NTHSynth/NTH_DSP/readme.txt

More information about the NTH Music Synthesizer can be found at: nthsynth.com
