NTHSynth/NTH_DSP/Firmware/readme.txt

To compile the NTH source code, create a new project for the PIC16F1937 microcontroller using MPLAB IDE.  Add the linker script (.lkr), include (.inc), and assembler files to the project (.asm).
