NTHSynth/NTH_DSP/PCB/readme.txt

Part: NTH
Revision: D

File List:

NTH-Rev-D-BOM.xls - Bill of Materials
NTH-d-centroid.csv - Centroid
NTH-d.brd - Eagle 4.16 board design

NTH-d.bot - Gerber, bottom layer
NTH-d.oln - Gerber, board outline
NTH-d.smt - Gerber, top soldermask
NTH-d.smb - Gerber, bottom soldermask
NTH-d.slk - Gerber, top silkscreen
NTH-d.top - Gerber, top layer
NTH-d.tsp - Gerber, top silkscreen
NTH-d.drd - Excellon Drill File
