NTHSynth/NTH_DSP/Enclosure/Enclosure-BOM.xls

NTH Rev D Enclosure BOM
Item # | Qty | MFG Part No. | Digikey Part No. | Mouser Part No. | Description | Notes
1 | 8 | 1848 | 1848K-ND | 534-1848 | Spacer, Round, 7/8"
2 | 24 |  | H360-ND |  | Machine Screw, Round Head, 6/32, 1/2"
3 | 8 |  | H220-ND |  | 6/32 Hex Nut
4 | 4 | 720 | 720K-ND | 534-720 | Rubber Foot
5 | 4 |  | H781-ND |  | 4/40 machine screw, pan head, 3/8" – for rubber feet
6 | 4 |  | H216-ND |  | 4/40 nut – for rubber feet
