NTHSynth/NTH_DSP/PCB/NTH-Rev-D-BOM.xls

NTH Rev D BOM
Item # | Type | SMT Qty | Thru Qty | Qty – Other | PCB Side | Ref Des | MFG Part No. | Digikey Part No. | Mouser Part No. | Description | Package | Notes
1 | SMT | 9 |  |  | Top | C1-C6, C101-C103 | C0805C104K3RACTU |  | 80-C0805C104K3R | Capacitor, Ceramic, 0.1uF | '0805
2 |  |  |  |  |  | C7 |  |  |  |  |  | Do not stuff
3 | SMT | 2 |  |  | Top | C11, C12 |  |  | 647-UWT1V2R2MCL2B | Capacitor, Electrolytic, 2.2uF | Radial
4 |  |  |  |  |  | C13 |  |  |  |  |  | Do not stuff
5 | SMT | 1 |  |  | Top | C104 | C0805C105K3PACTU |  | 80-C0805C105K3P | Capacitor, Ceramic, 1.0uF | '0805
6 | SMT | 13 |  |  | Top | D1-D12, D14 |  |  | 833-1N4148W-TP | Small Signal Diode | SOD123
7 | SMT | 3 |  |  | Top | D13, D101, D102 |  |  | 833-S2D-TP | Rectifier Diode
8 | Thru |  | 1 |  | Bottom | JP1 |  |  | 806-STX-3100-3N | 3.5mm Stereo Phone Jack
9 | Thru |  | 1 |  | Bottom | JP2 | 22-28-8061 |  | 538-22-28-8061 | ICSP Header
10 | Thru |  | 2 |  | Bottom | JP3, JP4 | SDS-50J | CP-2350-ND |  | MIDI Connector
11 | Other |  |  | 2 |  |  | 48SM006 |  | 48SM006 | M2 Self Tapping Screw |  | Anchors JP3 and JP4
12 | Thru |  | 13 |  | Top | LED1-LED13 | VAOL-5LSBY2 |  | 593-VAOL-5LSBY2 | LED | T1 ¾ | Use spacer (Item #10)
13 | Other |  |  | 13 |  | LED-SPACER | 8318 | 8318K-ND | 534-8318 |  |  | Spacer for LED1-LED13
14 | Thru |  | 8 |  | Top | POT1-POT8 |  |  | 312-619BF-5K | Potentiometer, Slide
15 | Thru |  | 3 |  | Top | POT9-POT11 |  |  | 317-2090F-10K | Potentiometer, 9mm, Rotary, Linear, 10k
16 | Thru |  | 2 |  | Top | PVOL, PRES |  |  | 317-2080F-10K | Potentiometer, 9mm, Rotary, Audio, 10k
17 | Thru |  | 1 |  | Top | PCUT |  |  | 317-2090F-100K | Potentiometer, 9mm, Rotary, Linear, 100k
18 | SMT | 2 |  |  | Top | R1, R101 |  |  | 667-ERJ-6GEYJ332V | R 3.3k ohms | '0805
19 | SMT | 1 |  |  | Top | R2 |  |  | 667-ERJ-6GEYJ471V | R 470 ohms | '0805
20 | SMT | 1 |  |  | Top | R102 |  |  | 667-ERJ-6GEYJ472V | R 4.7k ohms | '0805
21 | SMT | 2 |  |  | Top | R103-R104 |  |  | 667-ERJ-6GEYJ101V | R 100 ohms | '0805
22 | SMT | 2 |  |  | Top | R105-R106 |  |  | 667-ERJ-6GEYJ103V | R 10k ohms | '0805
23 | SMT | 2 |  |  | Top | R107-R108 |  |  | 667-ERJ-6GEYJ104V | R 100k ohms | '0805
24 | SMT | 2 |  |  | Top | R109-R110 |  |  | 667-ERJ-6GEYJ221V | R 220 ohms | '0805
25 | SMT | 1 |  |  | Top | R111 |  |  | 667-ERJ-6GEYJ222V | R 2.2k ohms | '0805 | Increase value up to 10k or remove R111 completely for greater resonance.
26 | SMT | 1 |  |  | Top | RN1 |  |  | 774-744C083102JP | Resistor Network, 8 pads, 1kohm
27 | SMT | 1 |  |  | Top | RN2 |  |  | 774-744C083221JP | Resistor Network, 8 pads, 220ohm
28 | SMT | 12 |  |  | Top | SW1-SW12 | TL3301SPF160QG | EG1869CT-ND |  | Tact Switch
29 | Other |  |  | 12 |  |  | 1S-BLK | EG4379-ND | 612-1S-BLK |  |  | Caps for SW1-SW12
30 | Thru |  | 2 |  | Top | SW13, SW14 | G12KP-YA-RO |  | 633-G12KP-YA-RO | Rocker Switch
31 | SMT | 1 |  |  | Top | U1 | PIC16F1937-I/PT | PIC16F1937-I/PT-ND | 579-PIC16F1937-I/PT | Microcontroller | TQFP-44
32 | SMT | 1 |  |  | Top | U2 | AD7302BRZ | AD7302BRZ-ND |  | DAC | SOIC-20
33 | SMT | 1 |  |  | Top | U3 |  |  | 511-L4931CD50-TR | Voltage Regulator | SO-8
34 | SMT | 1 |  |  | Top | U4 | PC900V0NIPXF |  | 852-PC900V0NIPXF | Photocoupler
35 | SMT | 3 |  |  | Top | U101-U103 |  |  | 579-MCP6001T-I/OT | Op Amp | SOT-23-5
36 | Thru |  | 1 |  | Bottom | BATTERY | 1294 |  | 534-1294 | Battery Holder |  | Attach to PCB with 4 eyelets (Item #33)
37 | Other |  |  | 4 |  | EYELET | 46 |  | 534-46 | Eyelet
Totals: |  | 62 | 34 | 31
