NTHSynth/NTH_DSP/Manual/NTH_manual_1.26.2012d.pdf

# The NTH Music Synthesizer

manual revision: 1.26.2012d

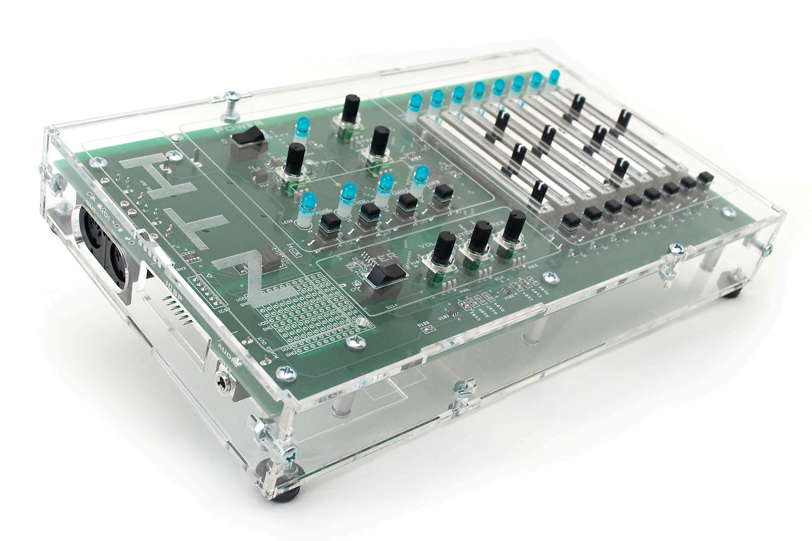
[picture p1: figure]

Thank you.

Congratulations on purchasing the Nth Music Synthesizer.

We hope that the NTH will put a smile on your face for years to come.

2

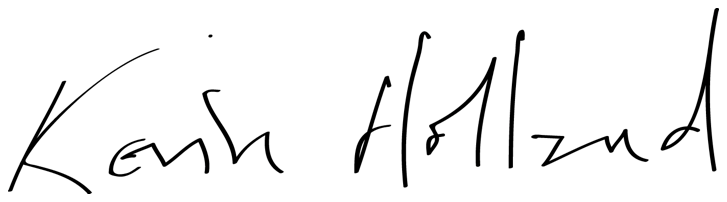
[picture p2: figure]
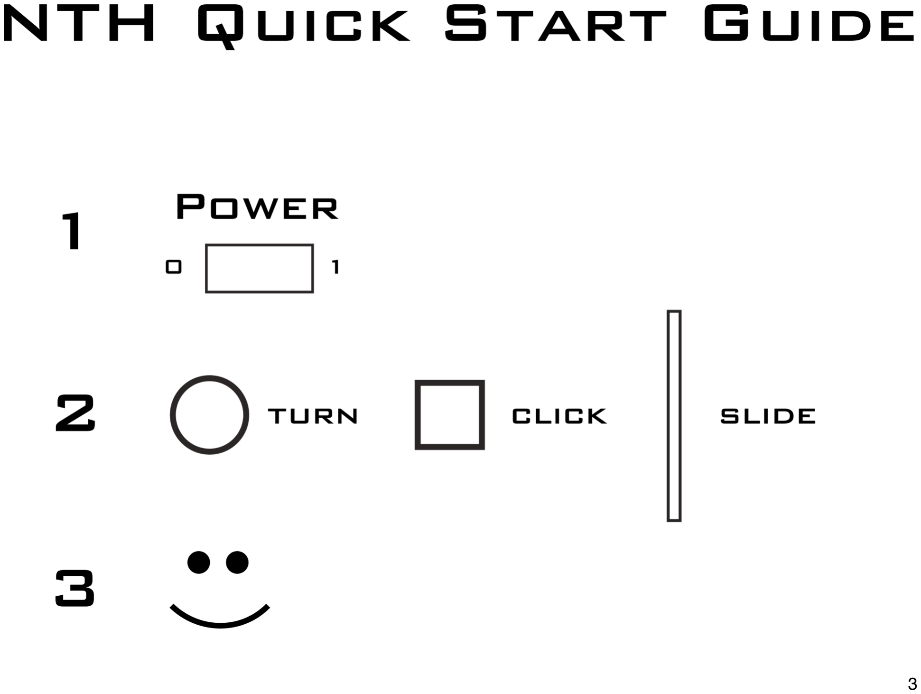
[picture p3: page 3]

3

## Contents

4

Introduction

Top Panel

Sequencer

Modulation

Filter

Signal Flow

Midi

Programming

Features & Specifications

Credits

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
## Introduction

We designed the NTH so that a user manual would be unnecessary. The NTH is so simple to use that a novice can quickly craft a variety of timbres. For the synth veteran, the NTH is a fun tool without layered menus and obscured features. Every synthesis parameter can be altered by simple manipulation of a knob, button, or slider.

If you are interested in the specifics of NTH operation, read on. We are excited to share.

5

6

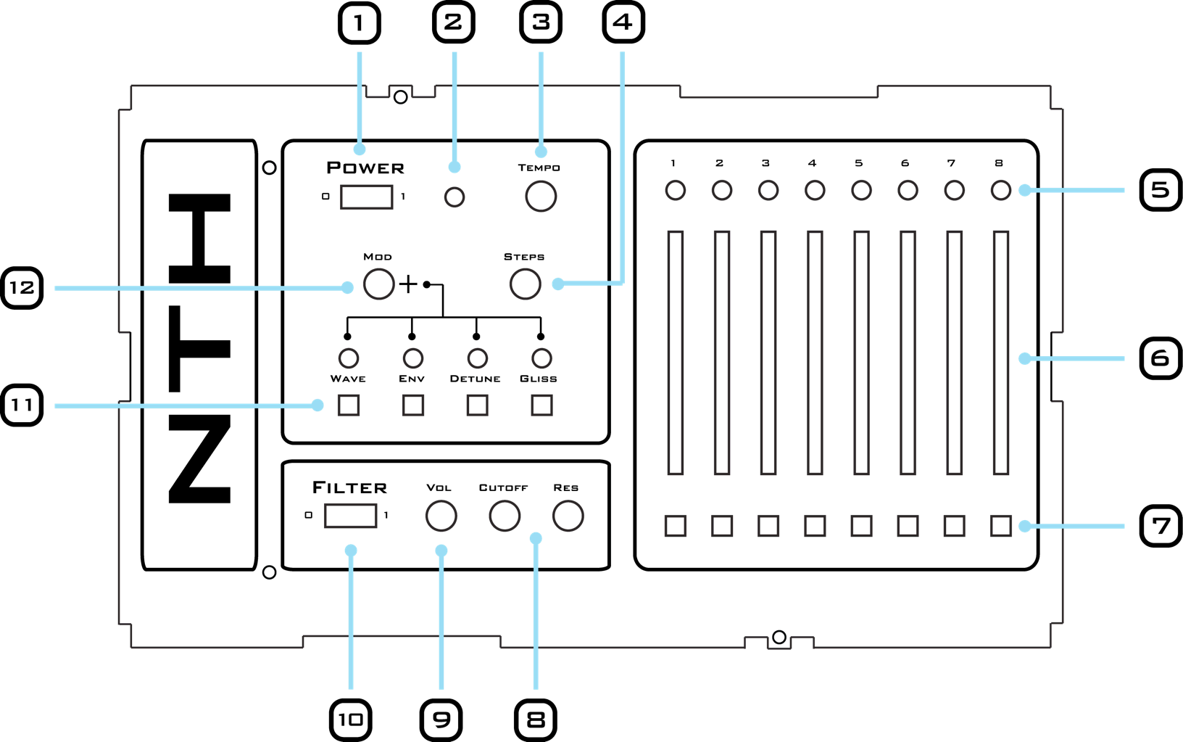
[picture p4: figure]

1 Power Toggle
2 Power indicator LED
3 Tempo Knob
4 Steps Knob
5 Step Indicator LEDs
6 Pitch Sliders

7 Step Toggles
8 Filter (Cutoff/Resonance Knobs) 9 Volume Knob
10 Filter Bypass Toggle
11 Modulation Toggles
12 Modulation Knob

## Top Panel

## Sequencer

7

Power up the NTH.
The sequencer
begins running.

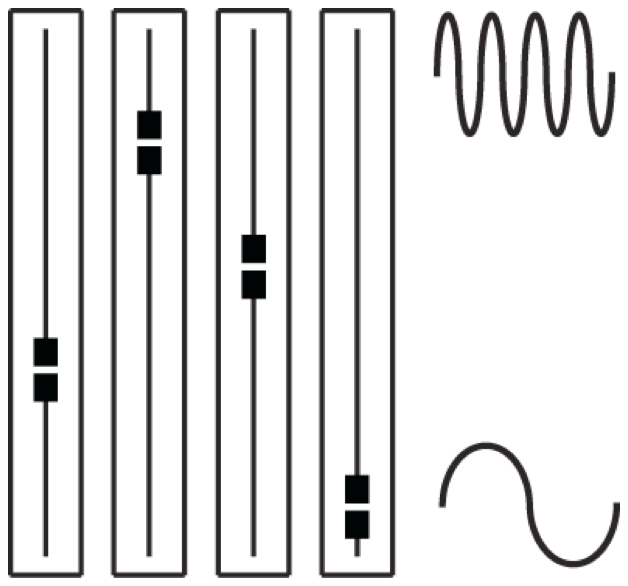
[picture p5: figure]

Change the pitch
of each step with
the sliders.

8

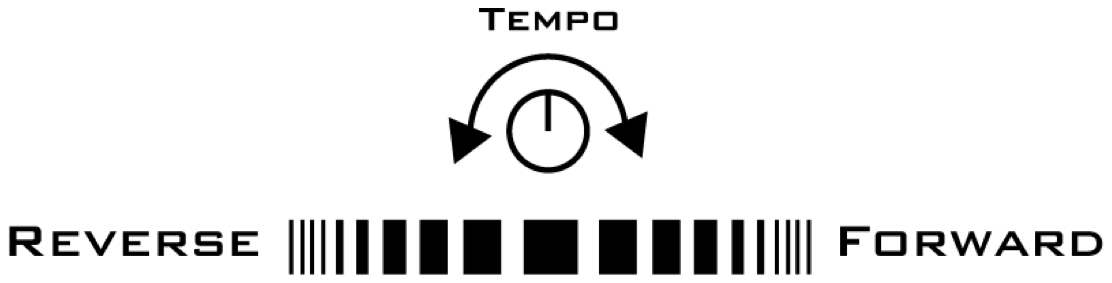
[picture p6: figure]

Adjust speed
and direction
of playback.

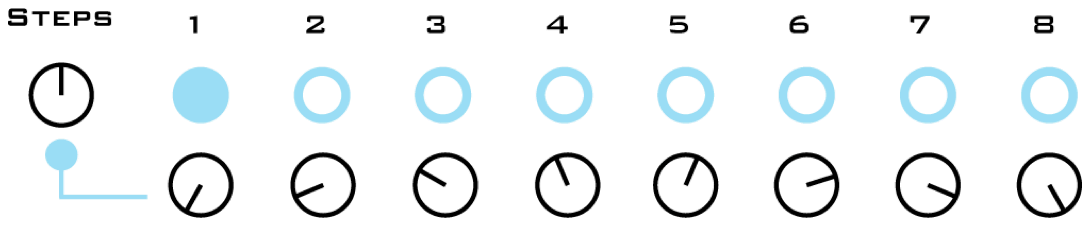
[picture p7: figure]

Toggle each step on or off.

Select the number
of steps in the
sequence.

## Modulation

Select any of the modulation parameters (Wave, Env, Detune, Gliss) by pressing the corresponding toggle. Adjust the sound by turning the Modulation Knob.

Each modulation parameter is described in the pages that follow.

9

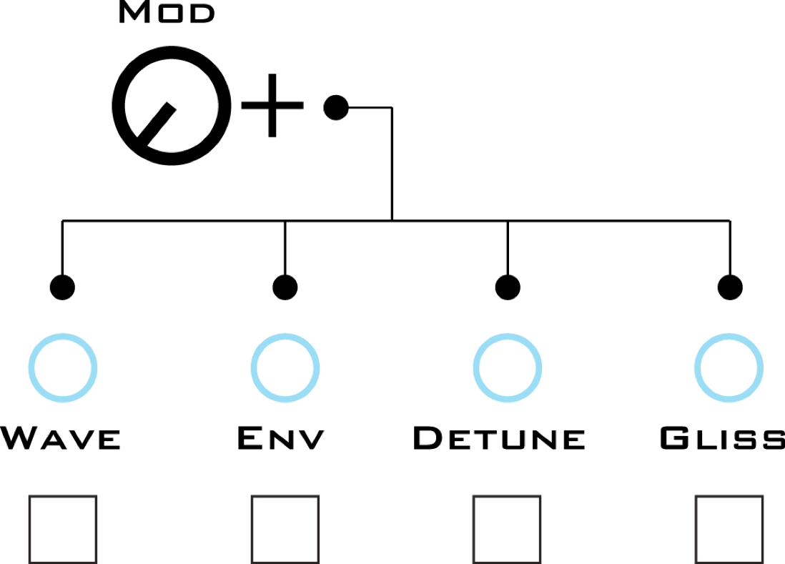
[picture p8: figure]

## Waveforms

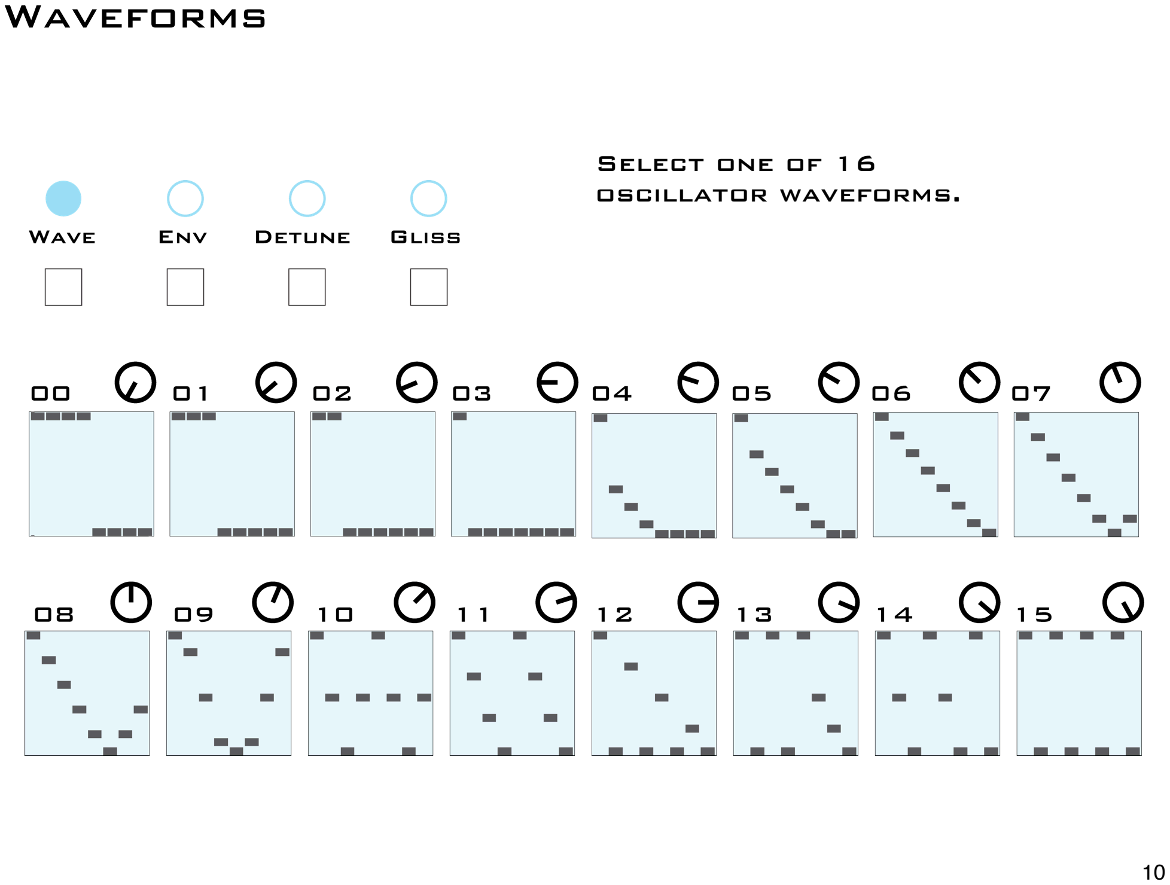
[picture p9: page 10]

10

Select one of 16
oscillator waveforms.

## Amplitude Envelopes

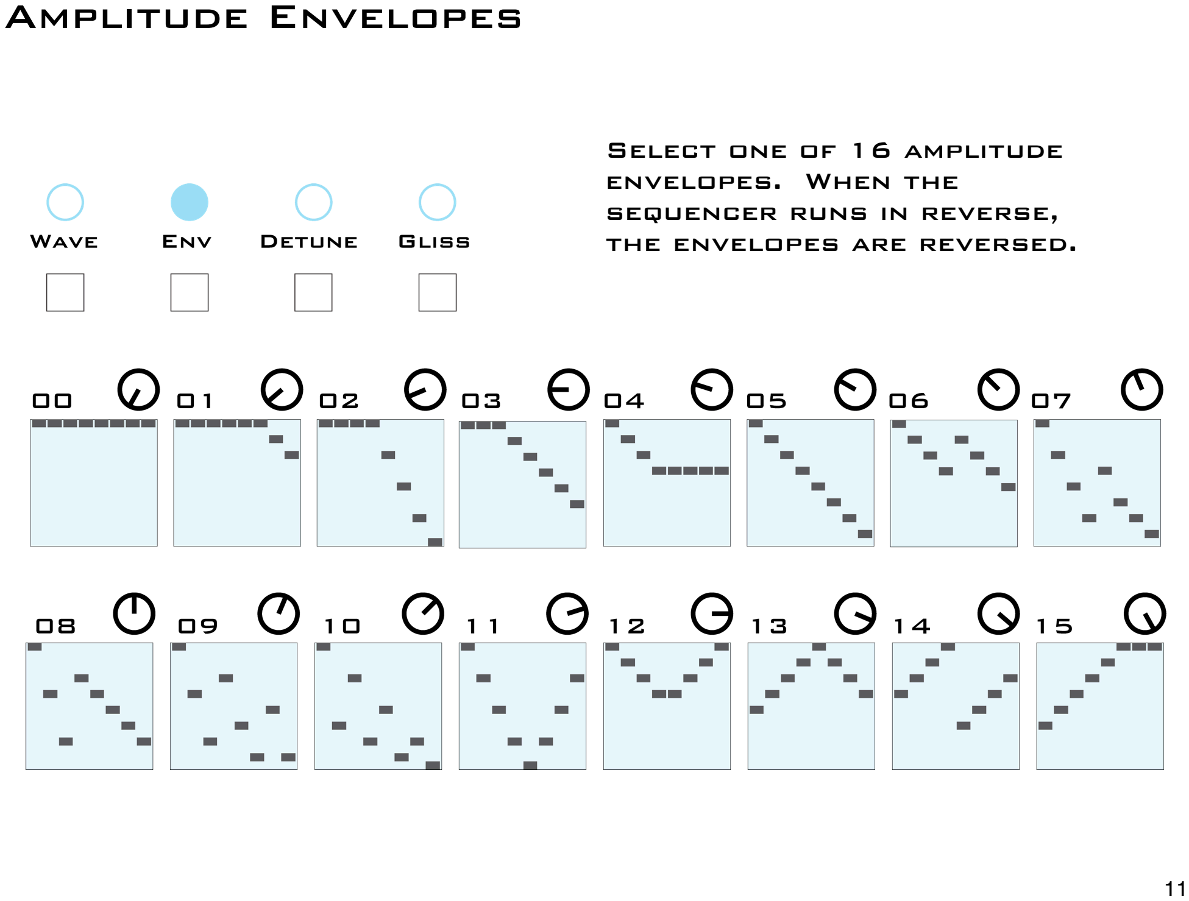
[picture p10: page 11]

11

Select one of 16 amplitude envelopes. When the
sequencer runs in reverse, the envelopes are reversed.

## Detune

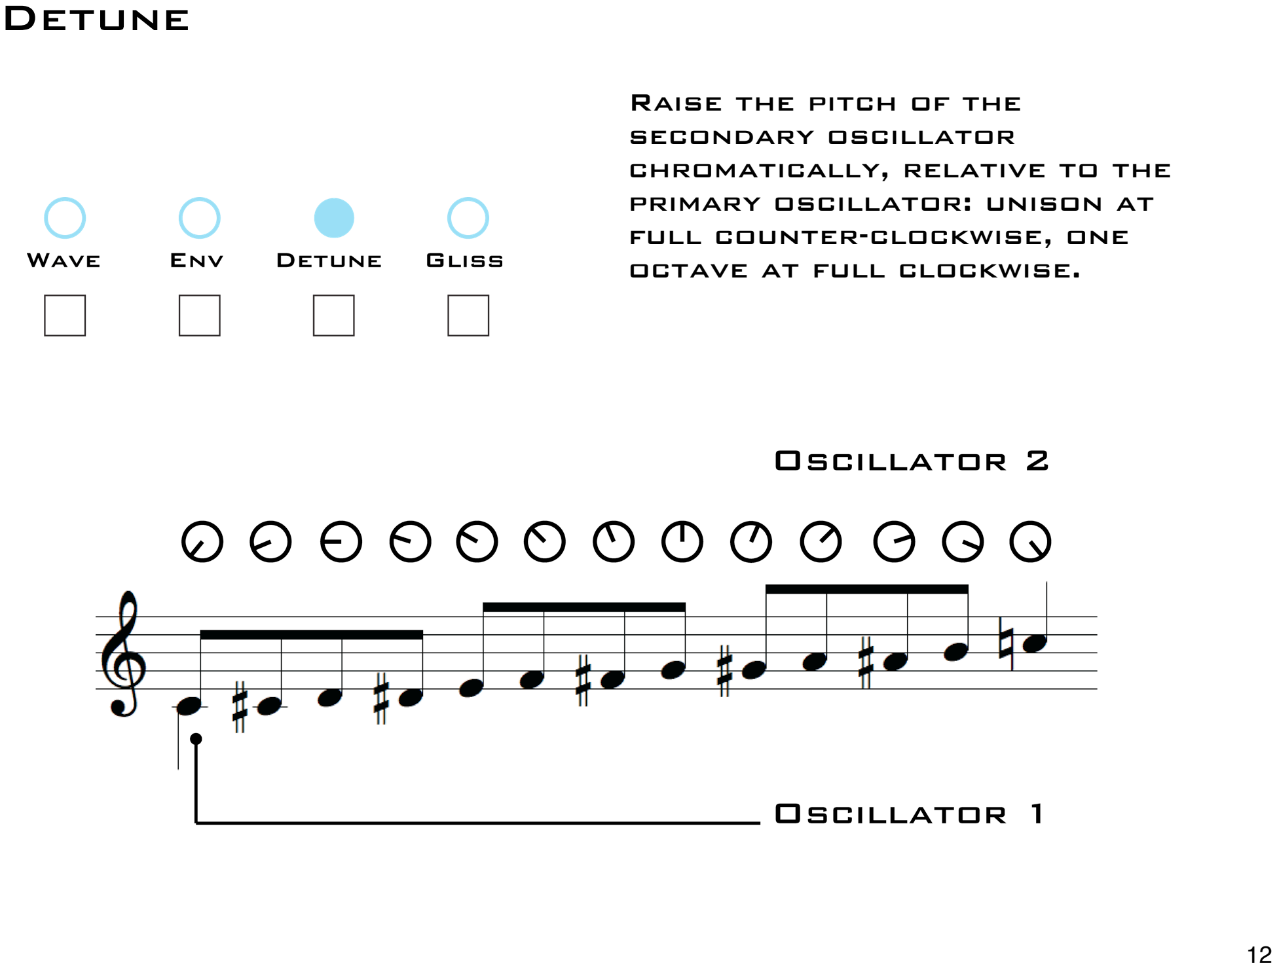
[picture p11: page 12]

12

Raise the pitch of the
secondary oscillator
chromatically, relative to the primary oscillator: unison at full counter-clockwise, one octave at full clockwise.

## Glissandi / Scales

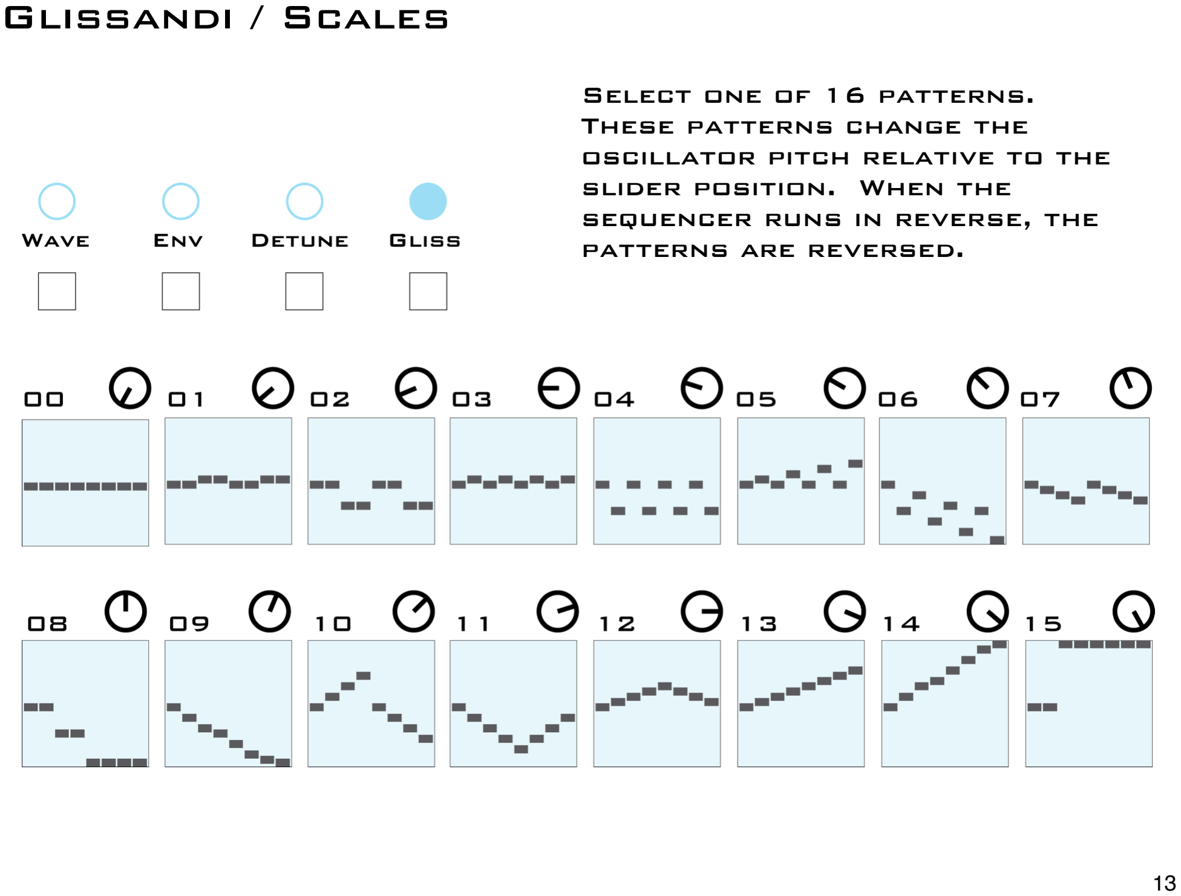
[picture p12: page 13]

13

Select one of 16 patterns. These patterns change the
oscillator pitch relative to the slider position. When the
sequencer runs in reverse, the patterns are reversed.

## Filter

Adjust the NTH's sound with the analog low-pass filter based on the Sallen-Key design.

The Cutoff Knob controls the cutoff frequency of the filter. The Resonance Knob boosts the output around the cutoff frequency.

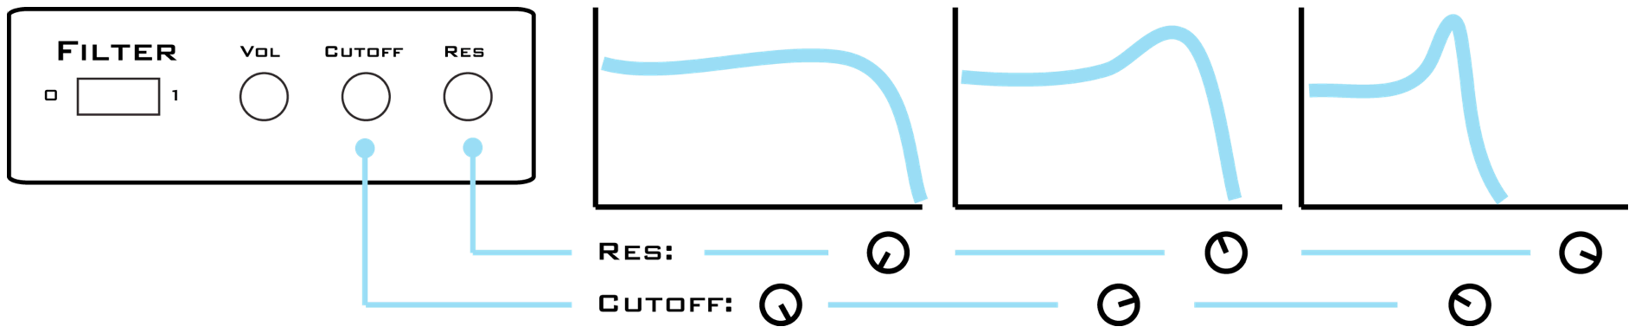
[picture p13: figure]

The NTH's filter is very aggressive. High resonance levels can result in distorted, raw, and noisy sounds. For a sweeter tone, roll the resonance knob counter-clockwise.

Bypass the NTH's filter by flipping the Filter Toggle to the "0" position.

14

## NTH Signal Flow

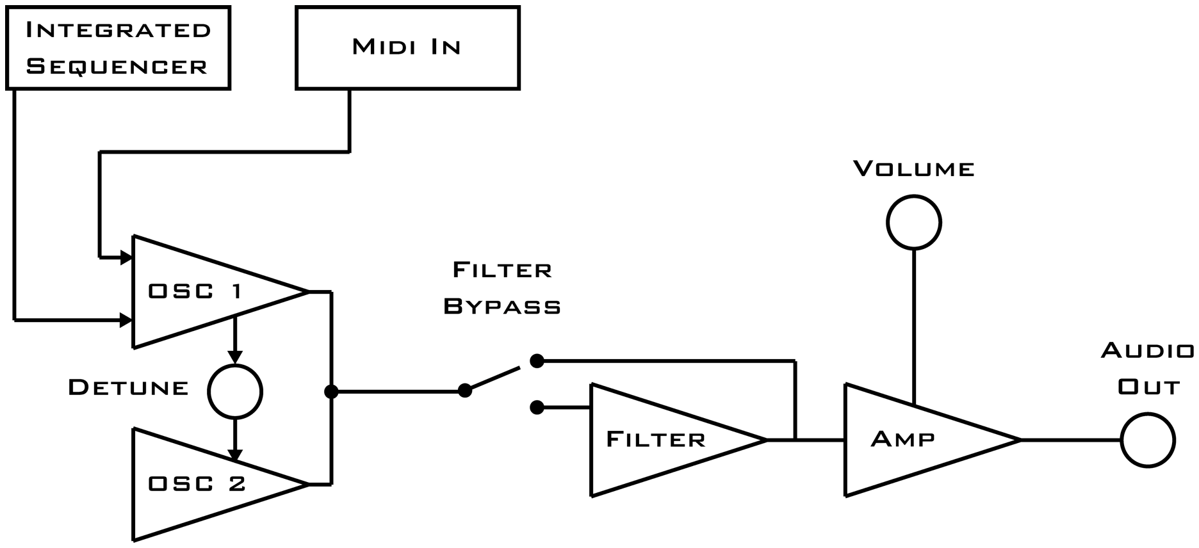
[picture p14: figure]

15

## MIDI

The NTH features standard MIDI in and out. It can be used in conjunction with external gear including keyboards, drum machines, samplers, and synthesizers. It can also interface with digital audio workstations on your computer.

At power-up, the NTH operates under control of its internal tempo clock and integrated step sequencer.

When a MIDI note is received, the integrated sequencer is disabled and the NTH enters monosynth mode, allowing you to play the NTH with an external controller. The internal tempo clock is still used to generate amplitude envelopes and gliss/scalar patterns.

When MIDI sync is received, the internal tempo clock is disabled and the NTH's integrated sequencer is controlled by the external MIDI sync.

When both MIDI notes and MIDI sync are received, the NTH operates in monosynth mode with amplitude envelopes and gliss/scalar patterns controlled by the external MIDI clock.

16

## MIDI Implementation Chart

17

Parameter | Function | CC | Range
Wave | Selects from 16 oscillator waveforms | 1 | 0 - 15
Env | Selects from 16 amplitude envelopes | 2 | 0 - 15
Detune | Detune secondary oscillator | 3 | 0 - 11
Gliss | Selects from 16 glissando / scalar patterns | 4 | 0 - 15
Steps | Selects sequence length | 5 | 1 - 8
Tempo | Rate/direction of sequencer | 6 | ~ 30 - 230 BPM
Gate | Selects looped or 1-shot amp envelope | 7 | 0 - 1
Note | Trigger MIDI notes F0 - G#5 | - | 17 - 80
Sync | Start / Stop / Continue / Clock | - | -

## Programming

The microcontroller programming port is a 6-pin header that adheres to the Microchip In Circuit Serial Programming specification. For details, see the datasheet of the NTH microcontroller (PIC16F1937).

We recommend the Microchip PICkit2 USB programmer and software.

18

## Features & Specifications

• Hackable open source design
- Electronic prototyping area
- Additional DAC channel reserved for DIY use
- PIC16F microcontroller with In Circuit Serial Programming (ICSP) port for firmware DIY & upgrades
• 8-bit digital oscillator
- 16 oscillator waveforms
- 16 amplitude envelopes
- Dual pitch with adjustable detune
- 16 glissando / scalar patterns
• | Analog low-pass filter with resonance (based on Sallen-Key design)
• | Integrated 8-step sequencer:
- 8 pitch sliders with toggle buttons
- Tempo control knob with reverse
- Sequence control knob
• | Standard MIDI in and MIDI out ports
• | 3.5mm line/headphone output with volume control
• | Lasercut and etched acrylic enclosure
• | Blue indicator LEDs
• | Powered by 9V battery
- Power consumption: 0.9W (100mA @ 9VDC) • | Dimensions: 10.26 ” x 6.11 ” x 2.125 ” • | Weight (Excluding Battery): 21.65 oz.

19

## Credits

NTH created by John Staskevich & Kevin Holland

nthsynth.com
highlyliquid.com
sineqube.com

Photography by Amy Glass

amyglass.dphoto.com

20
