NTHSynth/NTH_DSP/Firmware/src/frequencies.asm

		list p=16F1937
		#include	<p16f1937.inc>

; =================================
;
; Data in Program EEPROM
;
; =================================

freqdata	code	0x1800
; 00
		data	0x0000
		data	0x00B7

		data	0x0000
		data	0x00C1

		data	0x0000
		data	0x00CD

		data	0x0000
		data	0x00D9

		data	0x0000
		data	0x00E6

		data	0x0000
		data	0x00F4

		data	0x0001
		data	0x0002

		data	0x0001
		data	0x0012

		data	0x0001
		data	0x0022

		data	0x0001
		data	0x0033

		data	0x0001
		data	0x0046

		data	0x0001
		data	0x0059

		data	0x0001
		data	0x006e

		data	0x0001
		data	0x0083

		data	0x0001
		data	0x009b

		data	0x0001
		data	0x00b3

		data	0x0001
		data	0x00cd
; 10
		data	0x0001
		data	0x00e8

		data	0x0002
		data	0x0005

		data	0x0002
		data	0x0024

		data	0x0002
		data	0x0045

		data	0x0002
		data	0x0067

		data	0x0002
		data	0x008c

		data	0x0002
		data	0x00b3

		data	0x0002
		data	0x00dc

		data	0x0003
		data	0x0007

		data	0x0003
		data	0x0036
; 20
		data	0x0003
		data	0x0066

		data	0x0003
		data	0x009a

		data	0x0003
		data	0x00d1

		data	0x0004
		data	0x000b

		data	0x0004
		data	0x0049

		data	0x0004
		data	0x008a

		data	0x0004
		data	0x00cf

		data	0x0005
		data	0x0018

		data	0x0005
		data	0x0066

		data	0x0005
		data	0x00b8
; 30
		data	0x0006
		data	0x000f

		data	0x0006
		data	0x006c

		data	0x0006
		data	0x00cd

		data	0x0007
		data	0x0035

		data	0x0007
		data	0x00a3

		data	0x0008
		data	0x0017

		data	0x0008
		data	0x0092

		data	0x0009
		data	0x0015

		data	0x0009
		data	0x009f

		data	0x000a
		data	0x0031
; 40
		data	0x000a
		data	0x00cd

		data	0x000b
		data	0x0071

		data	0x000c
		data	0x001f

		data	0x000c
		data	0x00d8

		data	0x000d
		data	0x009b

		data	0x000e
		data	0x006a

		data	0x000f
		data	0x0046

		data	0x0010
		data	0x002e

		data	0x0011
		data	0x0025

		data	0x0012
		data	0x002a
; 50
		data	0x0013
		data	0x003e

		data	0x0014
		data	0x0063

		data	0x0015
		data	0x009a

		data	0x0016
		data	0x00e3

		data	0x0018
		data	0x003f

		data	0x0019
		data	0x00b0

		data	0x001b
		data	0x0037

		data	0x001c
		data	0x00d5

		data	0x001e
		data	0x008c

		data	0x0020
		data	0x005d
; 60
		data	0x0022
		data	0x004a

		data	0x0024
		data	0x0054

		data	0x0026
		data	0x007d

		data	0x0028
		data	0x00c7

		data	0x002b
		data	0x0034

		data	0x002d
		data	0x00c6

		data	0x0030
		data	0x007e

		data	0x0033
		data	0x0061

		data	0x0036
		data	0x006f

		data	0x0039
		data	0x00ab
; 70
		data	0x003d
		data	0x0019

		data	0x0040
		data	0x00bb

		data	0x0044
		data	0x0095

		data	0x0048
		data	0x00a9

		data	0x004c
		data	0x00fb

		data	0x0051
		data	0x008f

		data	0x0056
		data	0x0068

		data	0x005b
		data	0x008c

		data	0x0060
		data	0x00fd

		data	0x0066
		data	0x00c2
; 80
		data	0x006c
		data	0x00de

		data	0x0073
		data	0x0057

		data	0x007a
		data	0x0033

		data	0x0081
		data	0x0077

		data	0x0089
		data	0x002a

		data	0x0091
		data	0x0052

		data	0x0099
		data	0x00f7

		data	0x00a3
		data	0x001e

		data	0x00ac
		data	0x00d1

		data	0x00b7
		data	0x0018
; 90
		data	0x00c1
		data	0x00fb

		data	0x00cd
		data	0x0084

		data	0x00d9
		data	0x00bd

		data	0x00e6
		data	0x00af

		data	0x00f4
		data	0x0067
; wrap at 95
		data	0x0002
		data	0x00ef



		end
