NTHSynth/NTH_DSP/Firmware/src/data-eeprom.asm

		list p=16F1937
		#include	<p16f1937.inc>

; =================================
;
; Data in Data EEPROM
;
; =================================

data_eeprom	code	0xF000

; MIDI Channel Setting
		data	0x00


		end
